henri-rodrigues/guardanapeiro-modular/docs/Encaixe_Botao_e_PortaBisnaga.pdf

Novo encaixe: botão de pressão (substitui o trilho) | Folha 1/2 · 16/09/2026 · mm · PLA/PETG

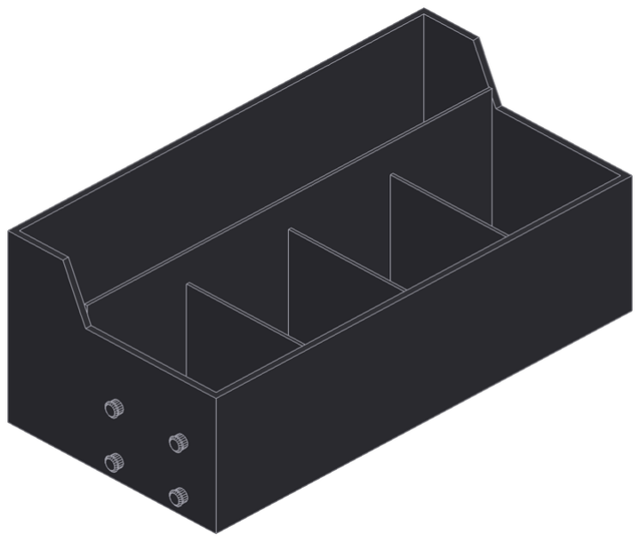
[picture p1: figure]

### ORGANIZADOR SEM NENHUM MÓDULO

só 4 botões de Ø6,8 mm em cada lateral — quase invisíveis de longe

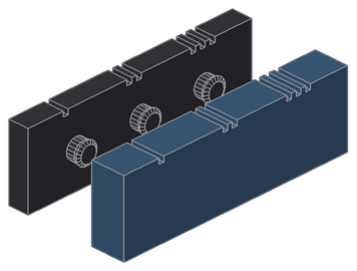
[picture p2: figure]

### PEÇAS DE TESTE DO BOTÃO

macho (3 cabeças: 6,6 / 6,8 / 7,0 mm) e fêmea — 1, 2 e 3 entalhes

## COMO FUNCIONA

O pino tem pescoço de Ø6,0 mm e cabeça abaulada de Ø6,8 mm. Ele entra num furo de Ø6,2 mm feito num disco fino de 1,3 mm, que flexiona na hora do encaixe e volta atrás da cabeça, travando. Depois do disco há um alívio de Ø8,6 mm, onde a cabeça se acomoda sem forçar.
São 4 botões por interface, num retângulo de 34 × 24 mm (y = 18 e 52; z = 9 e 33), o que segura o módulo contra giro e contra tombamento — mesmo sem trilho contínuo.

Vantagem em relação ao trilho: quando não há módulo instalado, a lateral fica lisa, com 4 pontinhos discretos, em vez de um trilho de 24 mm de altura aparecendo na peça.

Montagem: empurre o módulo de lado contra o organizador até ouvir/sentir o clique (antes era preciso descer o módulo por cima).

IMPORTANTE: imprima as duas peças de teste antes dos módulos — elas definem a cabeça certa para a sua impressora. Me diga qual das 3 (6,6 / 6,8 / 7,0) travou melhor e eu regero os STL.

Porta-bisnaga: versões de 3 e 6 bisnagas | Folha 2/2 · 16/09/2026 · mm · PLA/PETG

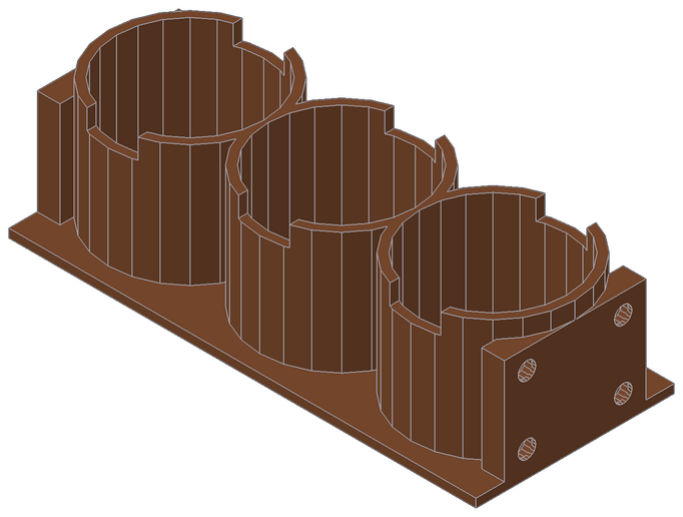
[picture p3: figure]

### VERSÃO A — 3 BISNAGAS EM LINHA

165 × 70 × 46 mm · volume sólido 106 cm³

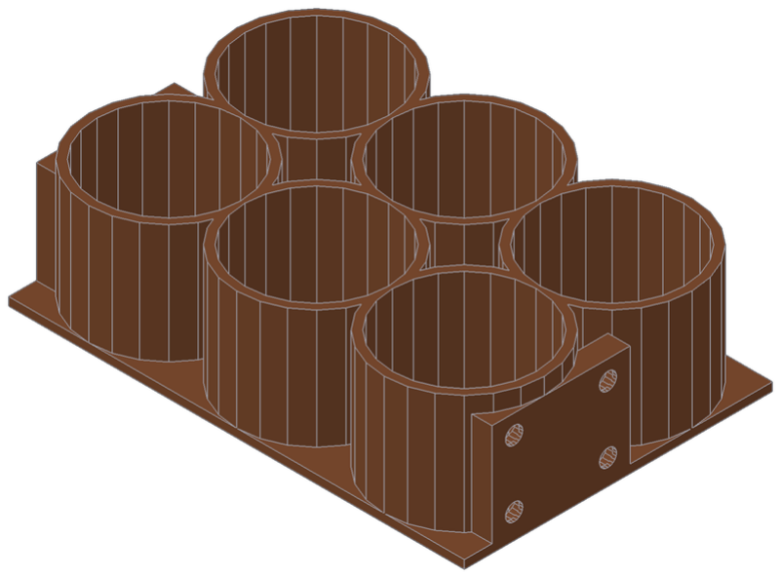
[picture p4: figure]

### VERSÃO B — 6 BISNAGAS (3 × 2)

165 × 111,5 × 46 mm · volume sólido 182 cm³

### DETALHES DOS DOIS

- Copo de Ø52 mm interno e 46 mm de altura — ajuste BOTTLE_D no script se a sua bisnaga for diferente.
- Copos vizinhos compartilham parede de 1,5 mm (centros a 53,5 mm), o que economiza material e espaço.
- Furo de dreno de Ø8 mm no fundo de cada copo.
- Versão A tem recortes laterais para tirar a bisnaga com os dedos; na versão B os copos do meio ficam cercados, então a retirada é por cima.
- Ambas têm a mesma interface de botão, então trocam de lugar com qualquer outro módulo.

### ARQUIVOS

Arquivo STL | Medidas (mm) | Observação
organizador_botoes.stl | 228 × 110 × 85 | substitui o da versão anterior
base_display_botoes.stl | 92 × 70 × 111 | bloco de encaixe mais alto (38 mm)
placa_cardapio.stl | 76 × 140 × 8 | não mudou
modulo_compartimentos_extras.stl | 48 × 70 × 60 | agora com botão
modulo_suporte_celular.stl | 68 × 70 × 84 | agora com botão
modulo_porta_bisnaga_3.stl | 169 × 70 × 46 | novo — 3 bisnagas
modulo_porta_bisnaga_6.stl | 169 × 111,5 × 46 | novo — 6 bisnagas
teste_botao_macho.stl / femea.stl | 10 × 70 × 22 | imprima primeiro
