henri-rodrigues/guardanapeiro-modular/docs/Modulos_Extras.pdf

# Sistema modular — visão geral

### MÓDULOS EXTRAS — ORGANIZADOR + CARDÁPIO DIGITAL

Folha 1/3 · 16/09/2026 · PLA/PETG preto · mm

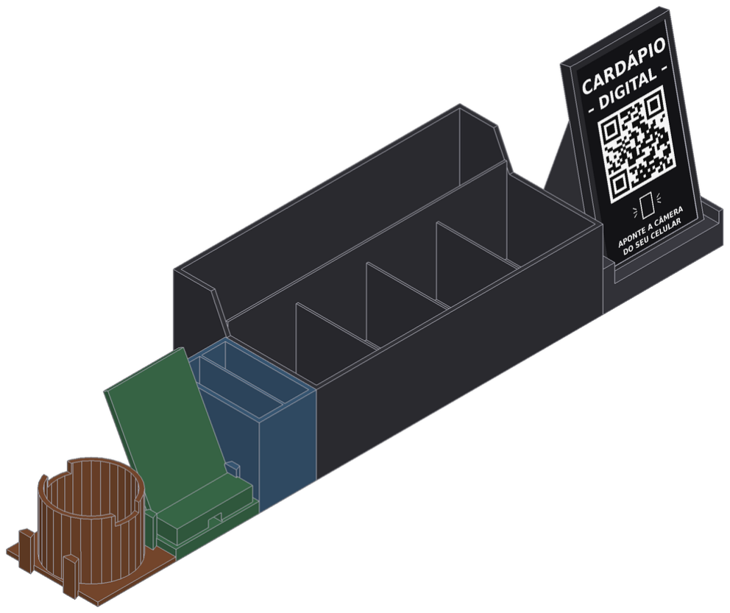
[picture p5: figure]

### ORGANIZADOR + 3 MÓDULOS ENCADEADOS NA LATERAL ESQUERDA

da esquerda p/ direita: porta-bisnaga · suporte de celular · compartimentos extras · organizador · base + placa

Porta-bisnaga | Suporte de celular | Compartimentos extras

## COMO FUNCIONA A INTERFACE

Todos os módulos usam o mesmo encaixe cauda-de-andorinha já validado entre organizador e base (6→9 mm, folga 0,15 mm).

- O organizador agora tem trilhos macho nos DOIS lados: o direito continua com a base do cardápio; o esquerdo é livre para qualquer módulo novo.
- Cada módulo tem um rasgo fêmea na face que encosta no organizador (ou no módulo anterior) — e um trilho macho na face de fora, para encaixar mais um módulo em fila.
- Montagem: cada peça desce por cima (vertical), como a base já fazia com o organizador.

### PROFUNDIDADE PADRÃO

Todo módulo tem 70 mm de profundidade (y), a mesma da base do display, com os trilhos nas mesmas posições
(y = 18 e 52 mm). Isso garante que qualquer combinação de módulos encaixa sem redesenhar nada.

### ARQUIVOS ATUALIZADOS

organizador_v2_trilhos_2_lados.stl substitui o organizador.stl da versão anterior (agora com trilho também do lado esquerdo). As demais peças (base, placa) continuam as mesmas.

### ENCAIXE

Mesma folga já testada na V1.1 (0,15 mm). Se seu teste de encaixe (folha anterior) pediu outra folga, me avise para eu regerar os STL com o valor certo.

# Especificação dos 3 módulos novos

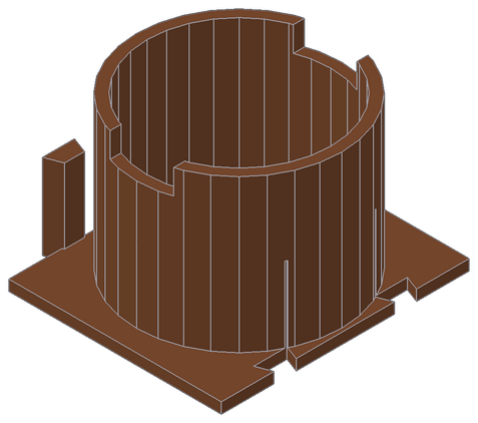
[picture p6: figure]

### MÓDULOS EXTRAS — ORGANIZADOR + CARDÁPIO DIGITAL

Folha 2/3 · 16/09/2026 · PLA/PETG preto · mm

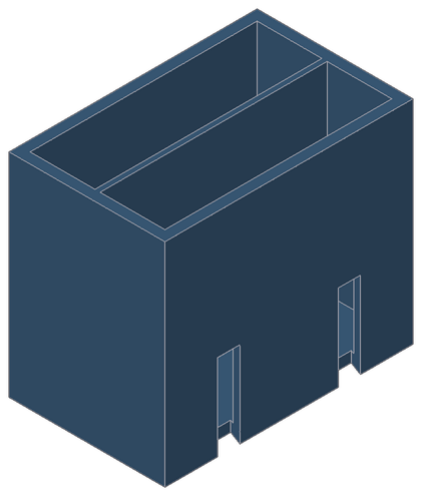
[picture p7: figure]

MÓDULO 1 — COMPARTIMENTOS EXTRAS

Largura × profundidade × altura
44 × 70 × 60 mm

Compartimentos
2 × 18,25 × 64 mm

Paredes / divisória

### 3 mm / 1,5 mm

Volume sólido

### 51.9 cm³

Bandeja simples com 2 vãos abertos — adoçante, canudo, palito ou um sachê extra. Mesma altura da parede frontal

do organizador (60 mm), para ficar visualmente alinhada.

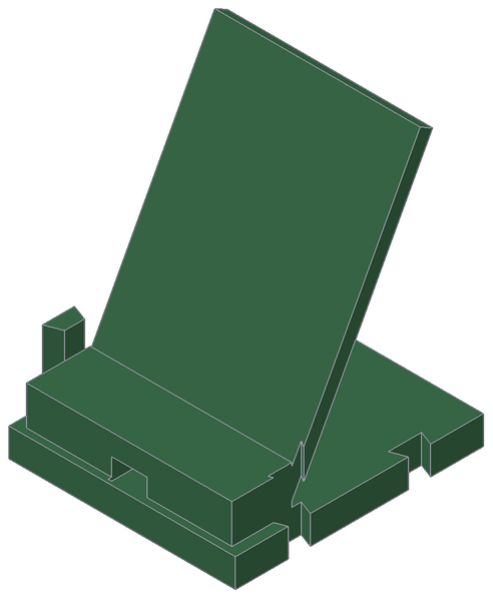
[picture p8: figure]

MÓDULO 2 — SUPORTE DE CELULAR/TABLET

Largura × profundidade × altura
64 × 70 × 84 mm

Inclinação do painel
28° da vertical

Bolso (funda) altura × profundidade 11 × 15 mm

Volume sólido

### 65.8 cm³

Painel de 4 mm apoiado num bolso frontal que segura a borda do aparelho; ranhura central de 10 mm para o cabo de carga passar por trás. Ajuste o ângulo (TILT2) no script

se preferir mais ou menos reclinado.

MÓDULO 3 — PORTA-BISNAGA

Largura × profundidade × altura
60 × 70 × 46 mm

Diâmetro interno do copo

### 52 mm

Furo de dreno
Ø 8 mm

Volume sólido

### 35.2 cm³

Copo cilíndrico com 2 recortes laterais para tirar a

bisnaga com os dedos, e furo de dreno no fundo. Ajuste BOTTLE_D no script para o diâmetro da sua

embalagem antes de imprimir.

# Impressão e montagem

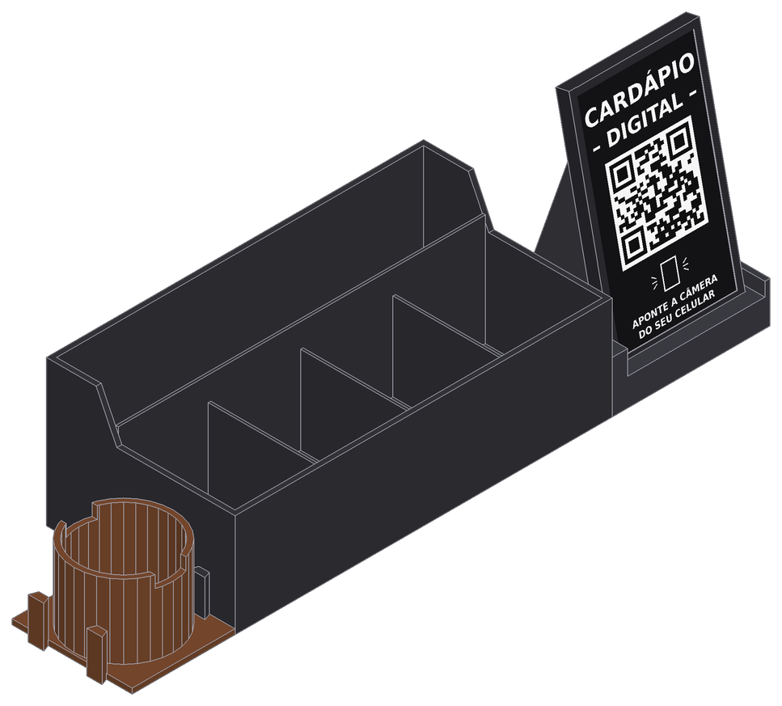
[picture p9: figure]

### MÓDULOS EXTRAS — ORGANIZADOR + CARDÁPIO DIGITAL

Folha 3/3 · 16/09/2026 · PLA/PETG preto · mm

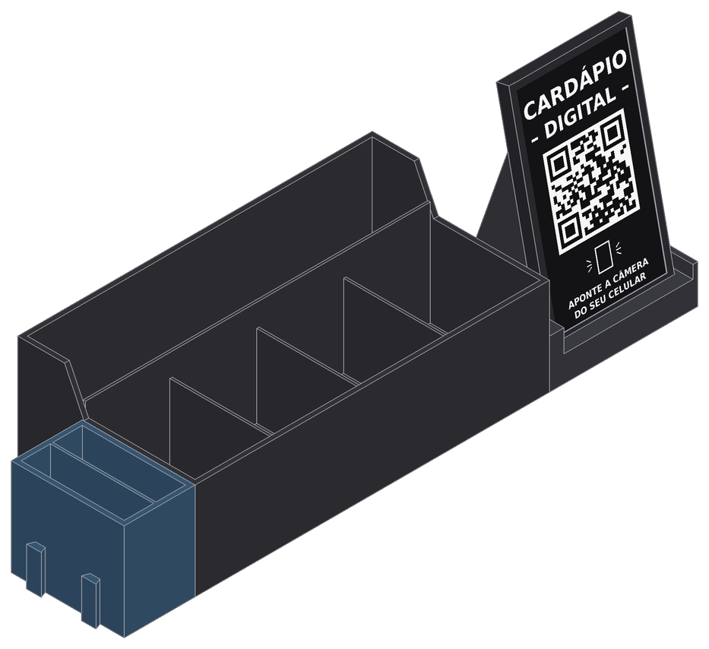
[picture p10: figure]
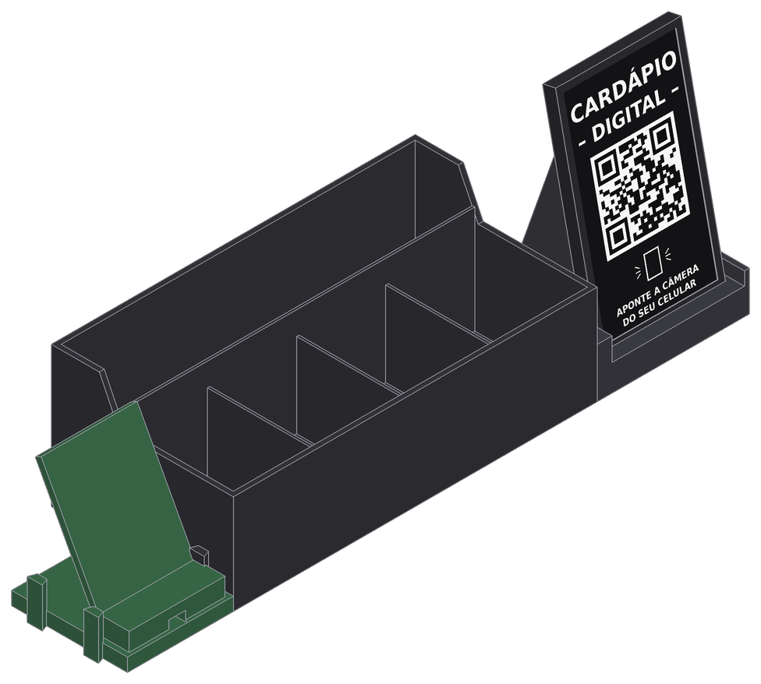
[picture p11: figure]

Compartimentos | Suporte de celular | Porta-bisnaga

### ARQUIVOS PARA IMPRESSÃO

Arquivo STL | Medidas (mm) | Posição na mesa | Sem suporte?
organizador_v2_trilhos_2_lados.stl | 228 × 110 × 85 | fundo na mesa | sim
modulo_compartimentos_extras.stl | 48 × 70 × 60 | fundo na mesa | sim
modulo_suporte_celular.stl | 68 × 70 × 84 | fundo na mesa | sim (painel apoiado)
modulo_porta_bisnaga.stl | 64 × 70 × 46 | fundo na mesa | sim

### COMO USAR

1. Se você já imprimiu o organizador da V1.1, troque só pelo novo organizador_v2_trilhos_2_lados.stl — o resto do conjunto (base, placa) não muda.
2. Escolha 1, 2 ou os 3 módulos e imprima com as mesmas configurações da V1.1: PLA/PETG, 4 paredes, 5 camadas de topo/fundo, 15% de preenchimento, sem suporte.
3. Encaixe o primeiro módulo por cima da lateral esquerda do organizador, deslizando para baixo até o fundo. Para encadear outro, repita o mesmo movimento encostando na face externa do módulo já encaixado.
4. A ordem dos módulos é livre — organize como preferir. Se algum ficar muito justo ou muito solto, ajuste a folga (mesma peça de teste da V1.1 serve para calibrar).
