henri-rodrigues/guardanapeiro-modular/site-3d/public/modelos/modulo_porta_bisnaga_6.stl

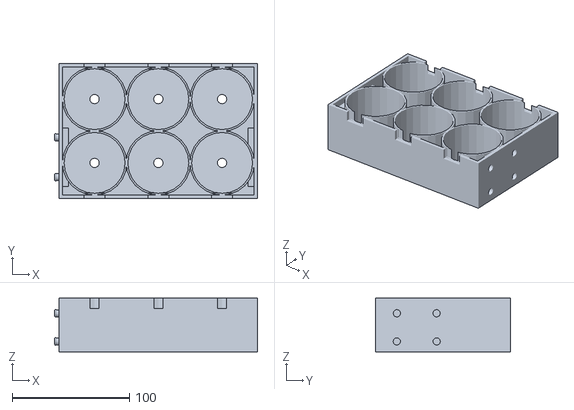
[picture p12: CAD file, 2026-09-18]
site-3d/public/modelos/modulo_porta_bisnaga_6.stl
173.2 x 114.8 x 46.0
