henri-rodrigues/guardanapeiro-modular/stl/modulo_compartimentos_2.stl

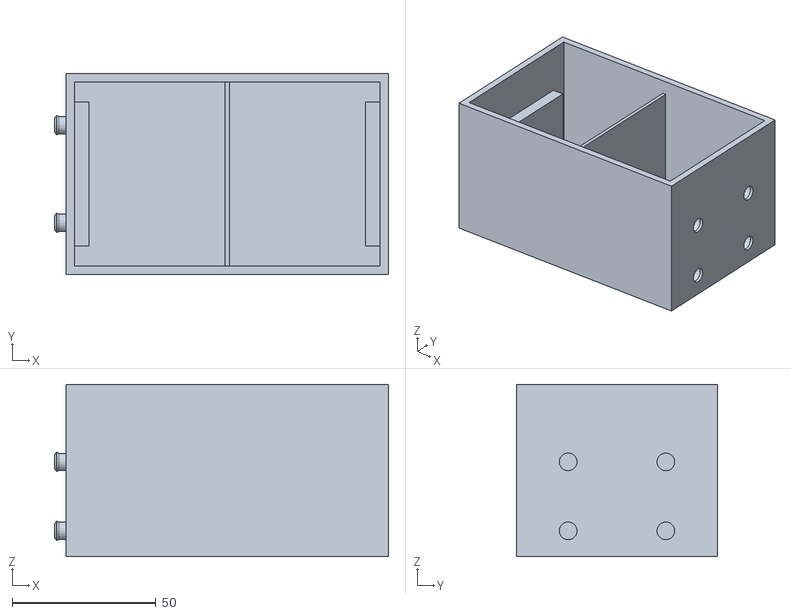
[picture p13: CAD file, 2026-09-18]
stl/modulo_compartimentos_2.stl
116.2 x 70.0 x 60.0
