henri-rodrigues/guardanapeiro-modular/site-3d/public/modelos/base_display_botoes.stl

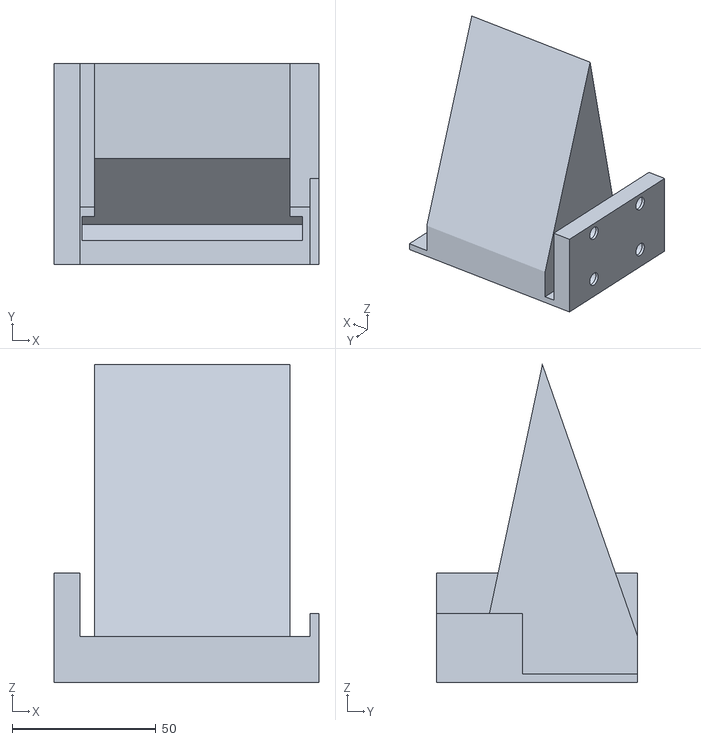
[picture p14: CAD file, 2026-09-18]
site-3d/public/modelos/base_display_botoes.stl
92.0 x 70.0 x 110.6
