henri-rodrigues/guardanapeiro-modular/stl/modulo_porta_bisnaga_3.stl

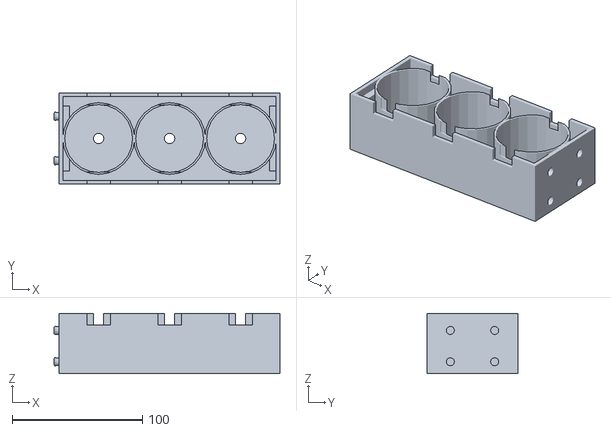
[picture p15: CAD file, 2026-09-18]
stl/modulo_porta_bisnaga_3.stl
173.2 x 70.0 x 46.0
