henri-rodrigues/guardanapeiro-modular/site-3d/public/modelos/organizador_botoes.stl

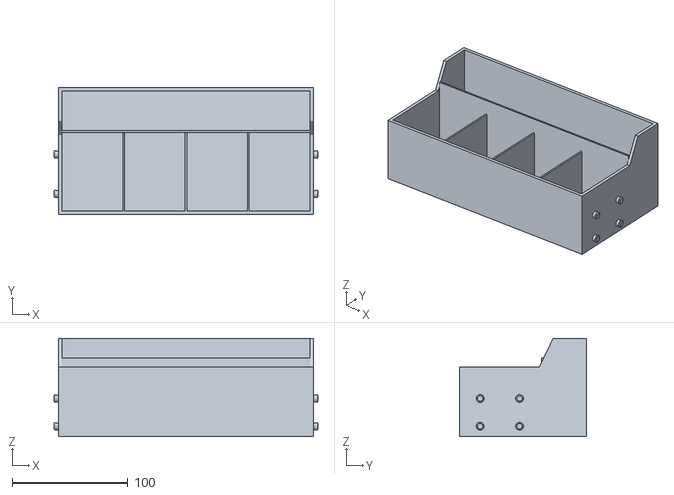
[picture p16: CAD file, 2026-09-18]
site-3d/public/modelos/organizador_botoes.stl
228.0 x 110.0 x 85.0
