henri-rodrigues/guardanapeiro-modular/stl/modulo_suporte_celular.stl

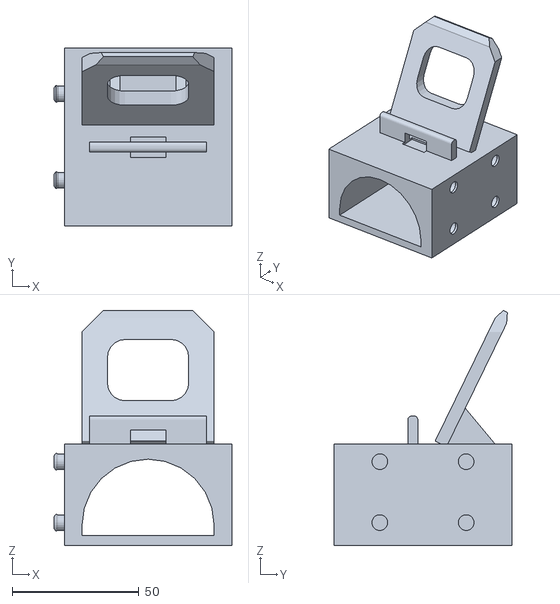
[picture p17: CAD file, 2026-09-18]
stl/modulo_suporte_celular.stl
70.0 x 70.0 x 92.5
