henri-rodrigues/guardanapeiro-modular/site-3d/public/modelos/modulo_compartimentos_3.stl

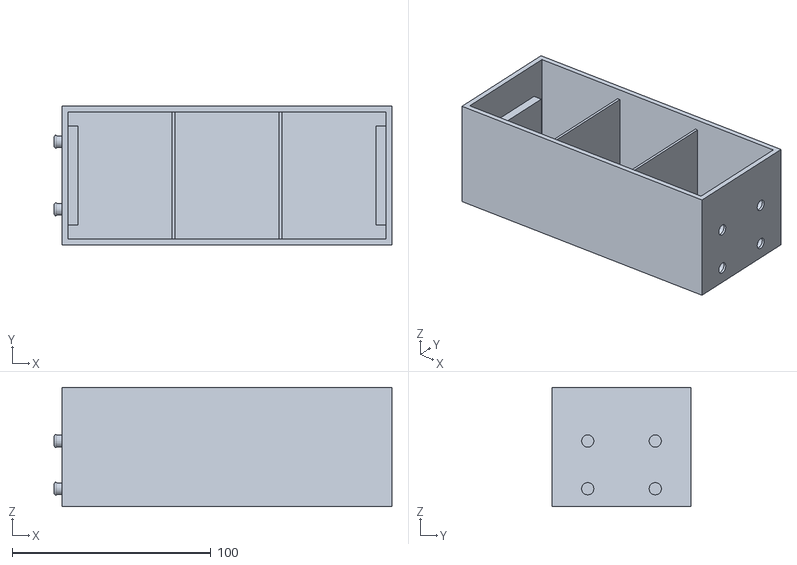
[picture p18: CAD file, 2026-09-18]
site-3d/public/modelos/modulo_compartimentos_3.stl
170.1 x 70.0 x 60.0
