henri-rodrigues/guardanapeiro-modular/stl/modulo_compartimentos_1.stl

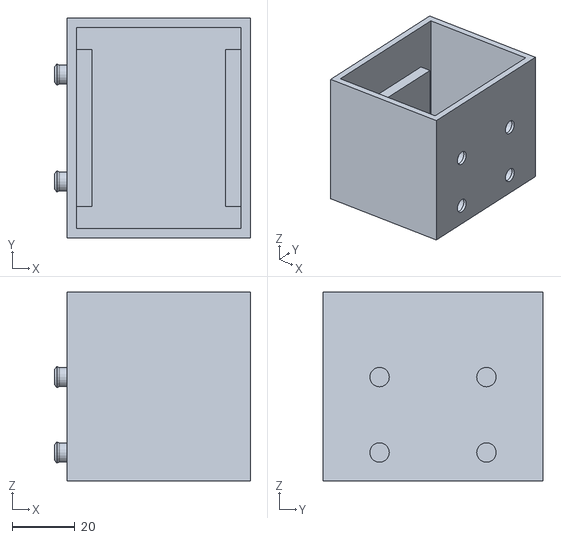
[picture p19: CAD file, 2026-09-18]
stl/modulo_compartimentos_1.stl
62.4 x 70.0 x 60.0
