henri-rodrigues/guardanapeiro-modular/stl/placa_cardapio.stl

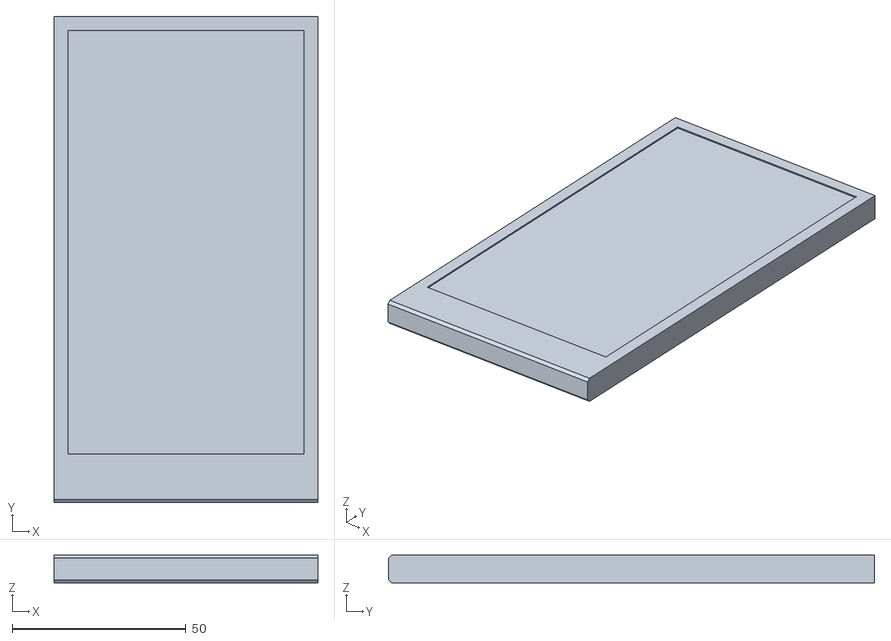
[picture p20: CAD file, 2026-09-18]
stl/placa_cardapio.stl
76.0 x 140.0 x 8.00
