henri-rodrigues/guardanapeiro-modular/stl/teste_botao_femea.stl

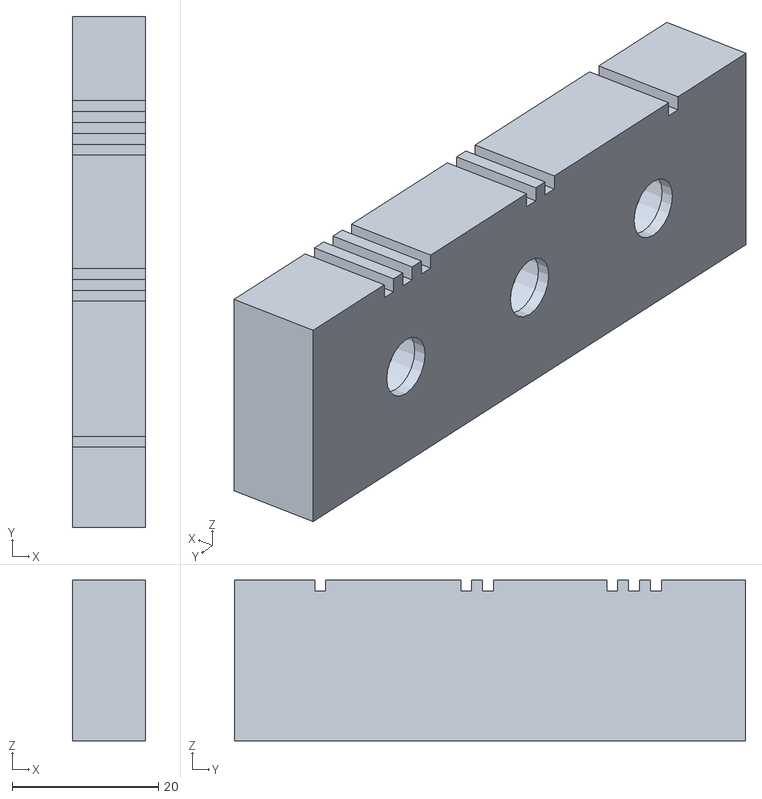
[picture p21: CAD file, 2026-09-18]
stl/teste_botao_femea.stl
10.0 x 70.0 x 22.0
