henri-rodrigues/guardanapeiro-modular/stl/modulo_compartimentos_extras.stl

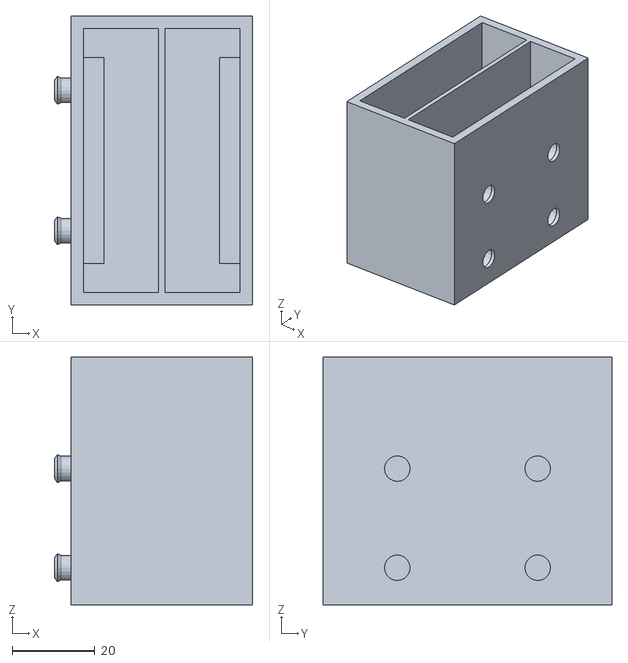
[picture p22: CAD file, 2026-09-18]
stl/modulo_compartimentos_extras.stl
48.0 x 70.0 x 60.0
