henri-rodrigues/guardanapeiro-modular/stl/teste_botao_macho.stl

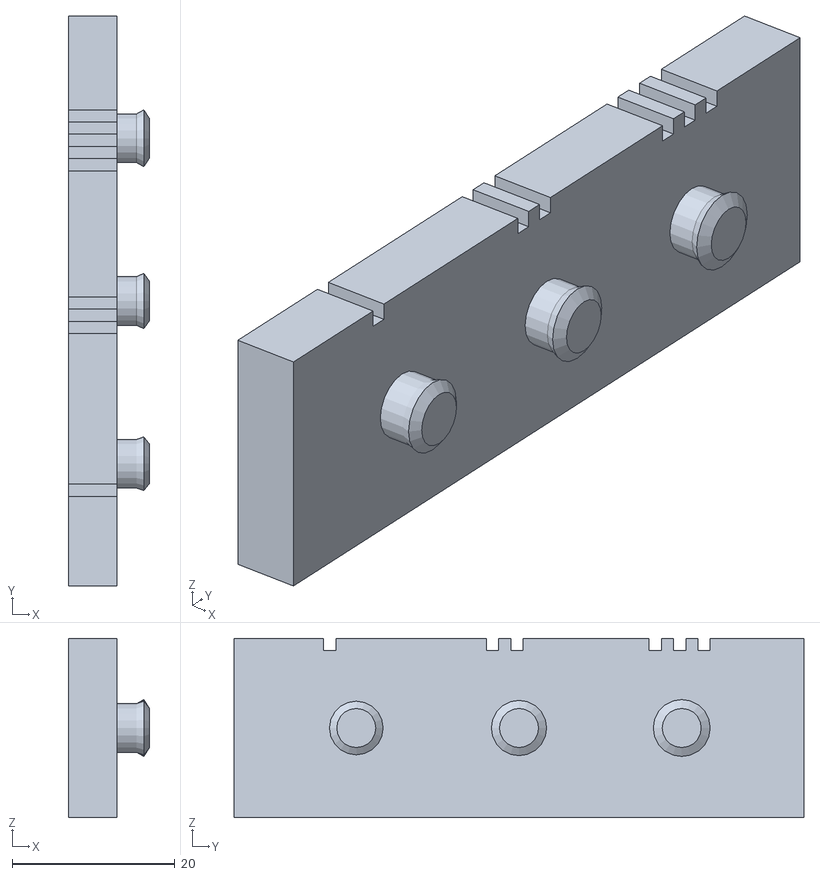
[picture p23: CAD file, 2026-09-18]
stl/teste_botao_macho.stl
10.0 x 70.0 x 22.0
