henri-rodrigues/guardanapeiro-modular/docs/Projeto_Organizador_Cardapio_Digital.pdf

# Vistas isométricas e visão geral

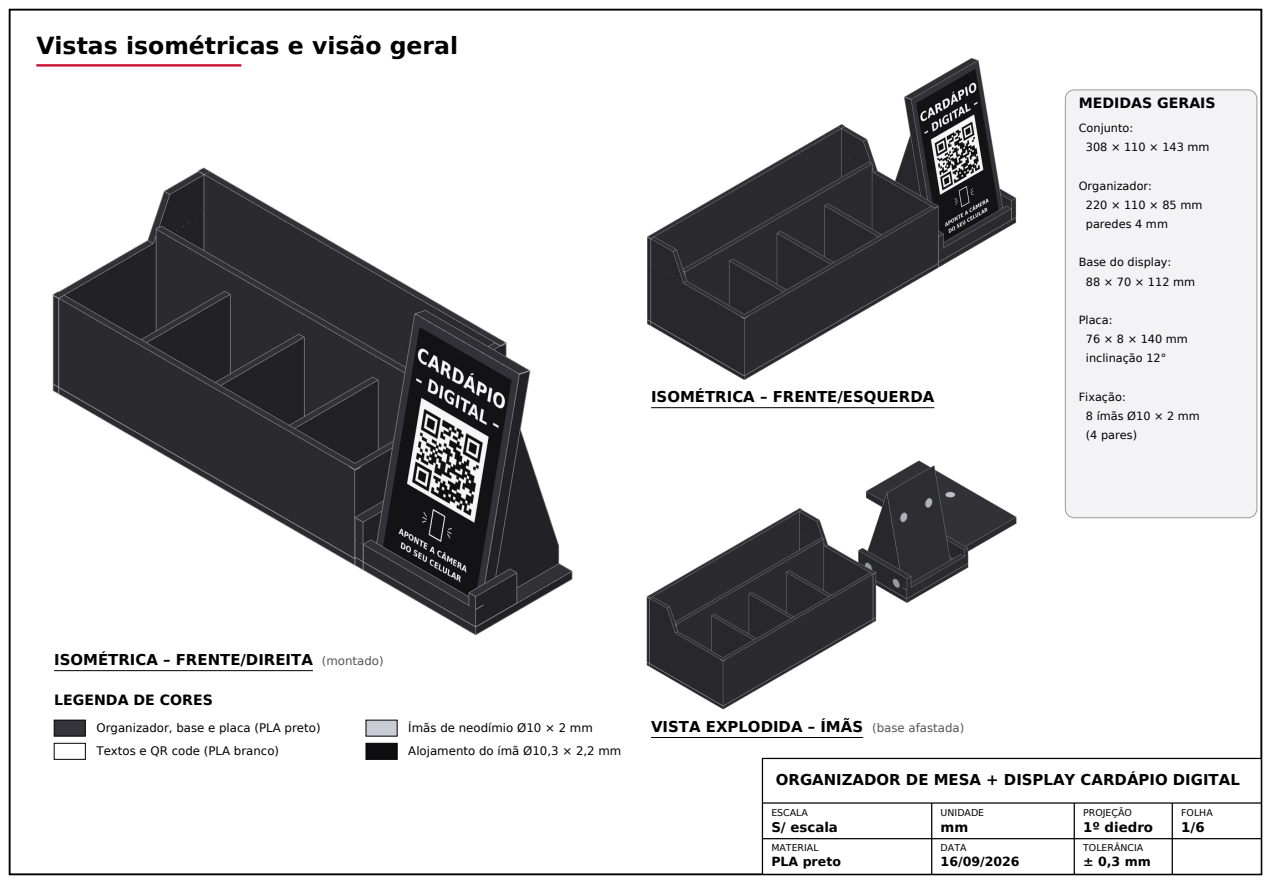
[picture p24: page 1]
MEDIDAS GERAIS; Conjunto:; Organizador:; paredes 4 mm; Placa:; inclinação 12°; Fixação:; 8 ímãs Ø10 × 2 mm; (4 pares)

Base do display:

ISOMÉTRICA – FRENTE/ESQUERDA

ISOMÉTRICA – FRENTE/DIREITA (montado)

LEGENDA DE CORES

Ímãs de neodímio Ø10 × 2 mm

VISTA EXPLODIDA – ÍMÃS (base afastada)

Organizador, base e placa (PLA preto)

Textos e QR code (PLA branco)

Alojamento do ímã Ø10,3 × 2,2 mm

ORGANIZADOR DE MESA + DISPLAY CARDÁPIO DIGITAL

ESCALA S/ escala | UNIDADE mm | PROJEÇÃO 1º diedro | FOLHA 1/6

MATERIAL PLA preto | DATA 16/09/2026 | TOLERÂNCIA ± 0,3 mm

# Vista frontal e vista superior

# CARDÁPIO

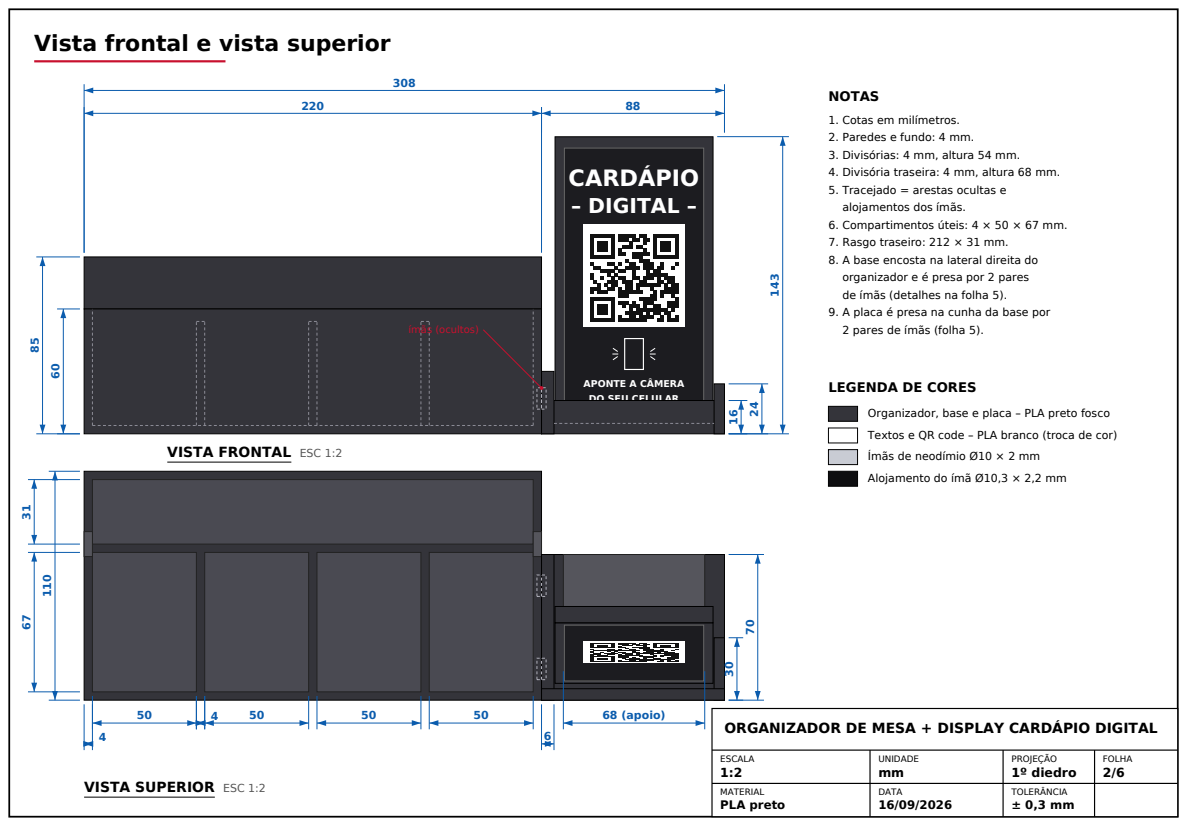
[picture p25: page 2]
ESCALA 1:2; UNIDADE mm; PROJEÇÃO 1º diedro; FOLHA 2/6; – DIGITAL –; ímãs (ocultos); 68 (apoio); NOTAS

1. Cotas em milímetros.
2. Paredes e fundo: 4 mm.
3. Divisórias: 4 mm, altura 54 mm.
4. Divisória traseira: 4 mm, altura 68 mm.
5. Tracejado = arestas ocultas e
alojamentos dos ímãs.
6. Compartimentos úteis: 4 × 50 × 67 mm.
7. Rasgo traseiro: 212 × 31 mm.
8. A base encosta na lateral direita do
organizador e é presa por 2 pares
de ímãs (detalhes na folha 5).
9. A placa é presa na cunha da base por
2 pares de ímãs (folha 5).

APONTE A CÂMERA
DO SEU CELULAR

LEGENDA DE CORES

Organizador, base e placa – PLA preto fosco

Textos e QR code – PLA branco (troca de cor)
Ímãs de neodímio Ø10 × 2 mm

VISTA FRONTAL ESC 1:2

Alojamento do ímã Ø10,3 × 2,2 mm

ORGANIZADOR DE MESA + DISPLAY CARDÁPIO DIGITAL

VISTA SUPERIOR ESC 1:2

# Vistas laterais

### VISTA LATERAL DIREITA – ORGANIZADOR ESC 1:1,25

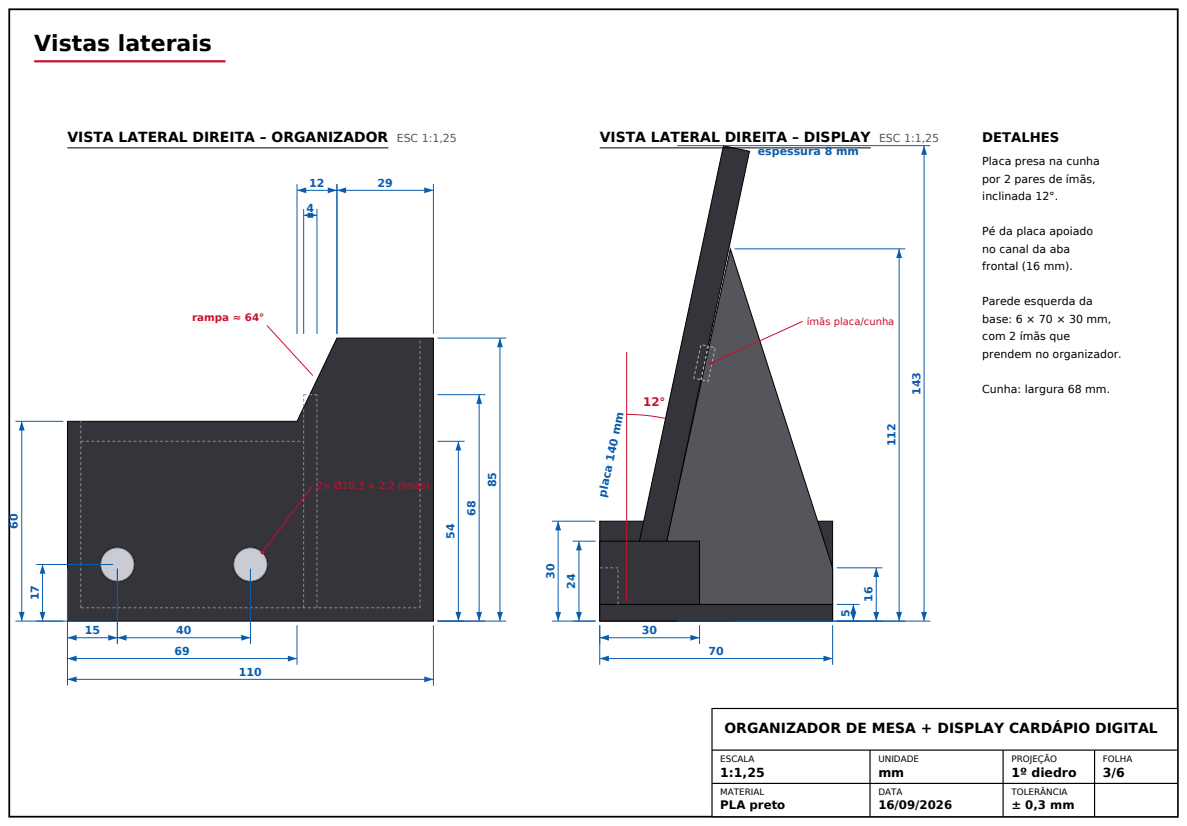
[picture p26: page 3]
ESCALA 1:1,25; UNIDADE mm; PROJEÇÃO 1º diedro; FOLHA 3/6; 2× Ø10,3 × 2,2 (ímãs); rampa ≈ 64°; ímãs placa/cunha; espessura 8 mm; placa 140 mm; DETALHES

VISTA LATERAL DIREITA – DISPLAY ESC 1:1,25

Placa presa na cunha
por 2 pares de ímãs,
inclinada 12°.

Pé da placa apoiado
no canal da aba
frontal (16 mm).

Parede esquerda da
base: 6 × 70 × 30 mm,
com 2 ímãs que
prendem no organizador.

Cunha: largura 68 mm.

ORGANIZADOR DE MESA + DISPLAY CARDÁPIO DIGITAL

# Detalhe da placa e lista de peças

# CARDÁPIO

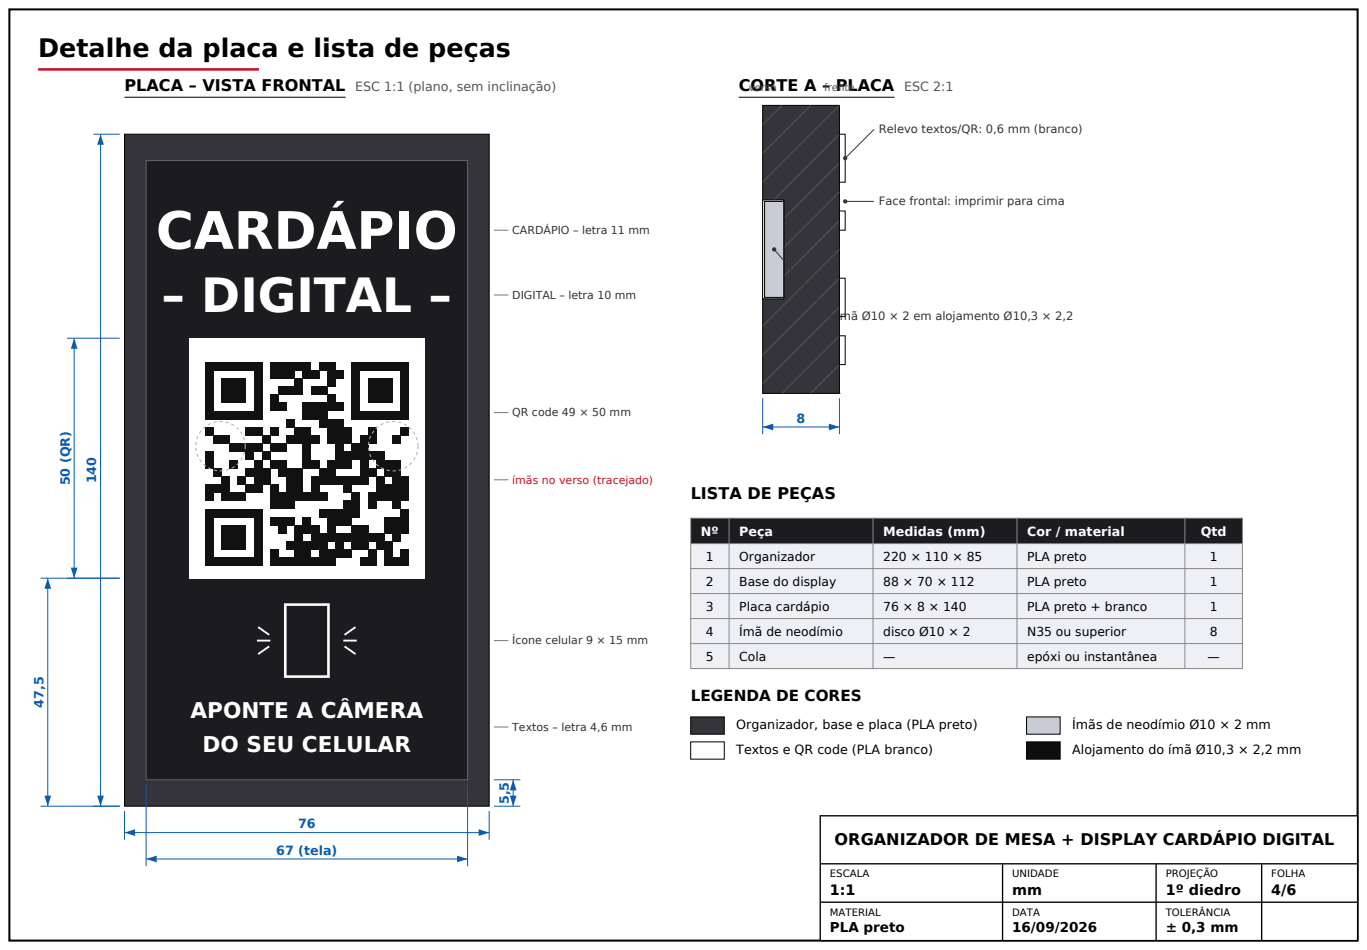
[picture p27: page 4]
ESCALA 1:1; UNIDADE mm; PROJEÇÃO 1º diedro; FOLHA 4/6; – DIGITAL –; 67 (tela); verso; frente

PLACA – VISTA FRONTAL ESC 1:1 (plano, sem inclinação)

CORTE A – PLACA ESC 2:1

Relevo textos/QR: 0,6 mm (branco)

Face frontal: imprimir para cima

CARDÁPIO – letra 11 mm

DIGITAL – letra 10 mm

Ímã Ø10 × 2 em alojamento Ø10,3 × 2,2

QR code 49 × 50 mm

ímãs no verso (tracejado)

LISTA DE PEÇAS

Nº | Peça | Medidas (mm) | Cor / material | Qtd

1 | Organizador | 220 × 110 × 85 | PLA preto | 1

2 | Base do display | 88 × 70 × 112 | PLA preto | 1

3 | Placa cardápio | 76 × 8 × 140 | PLA preto + branco | 1
4 | Ímã de neodímio | disco Ø10 × 2 | N35 ou superior | 8

Ícone celular 9 × 15 mm

5 | Cola | — | epóxi ou instantânea | —

LEGENDA DE CORES

APONTE A CÂMERA
DO SEU CELULAR

Textos – letra 4,6 mm

Organizador, base e placa (PLA preto)

Ímãs de neodímio Ø10 × 2 mm

Textos e QR code (PLA branco)

Alojamento do ímã Ø10,3 × 2,2 mm

ORGANIZADOR DE MESA + DISPLAY CARDÁPIO DIGITAL

# Fixação por ímãs

### BASE – LATERAL ESQUERDA ESC 1:1,25

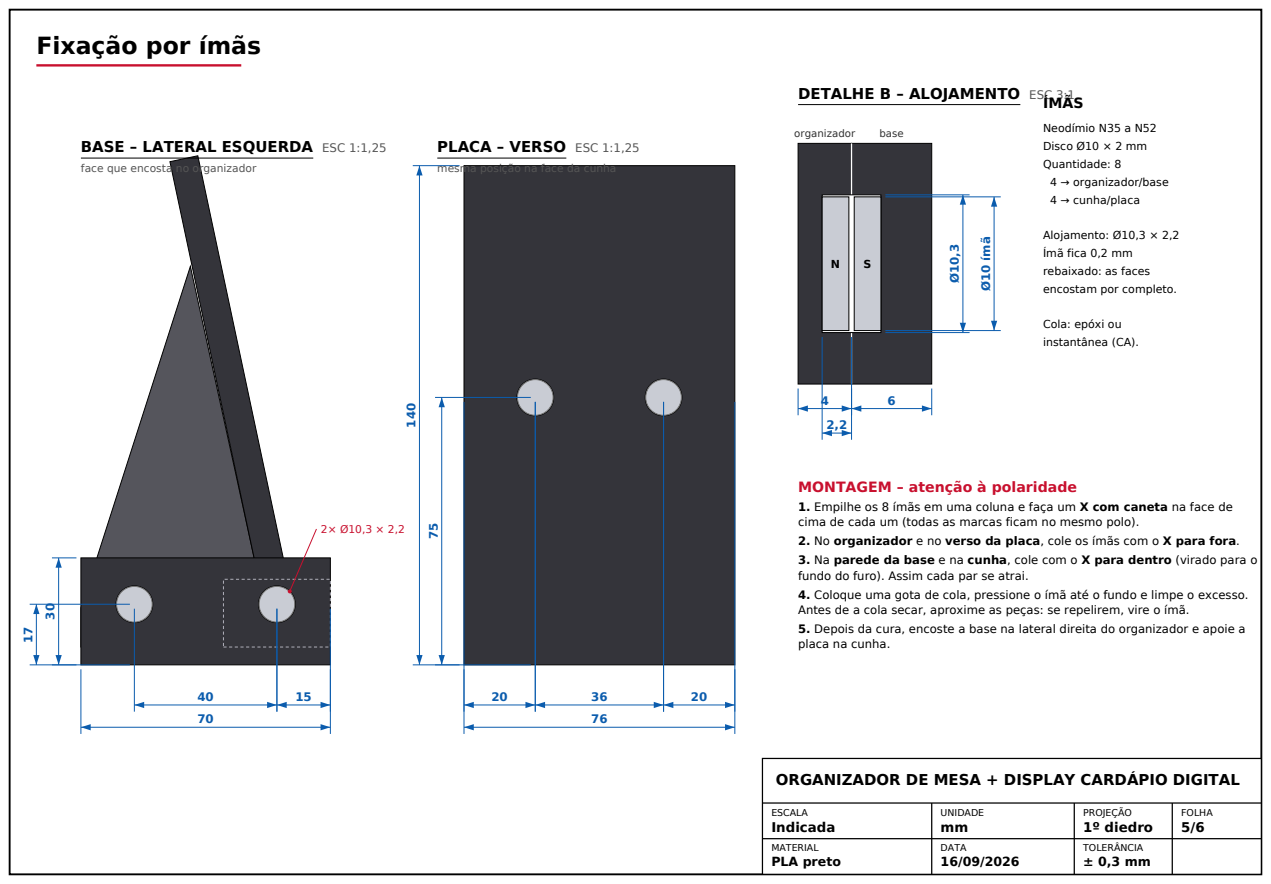
[picture p28: page 5]
ESCALA Indicada; UNIDADE mm; PROJEÇÃO 1º diedro; FOLHA 5/6; organizador; base; Ø10 ímã; ÍMÃS; Neodímio N35 a N52; Disco Ø10 × 2 mm; Quantidade: 8; 4 → organizador/base; 4 → cunha/placa

DETALHE B – ALOJAMENTO ESC 3:1

PLACA – VERSO ESC 1:1,25

face que encosta no organizador

mesma posição na face da cunha

Alojamento: Ø10,3 × 2,2
Ímã fica 0,2 mm
rebaixado: as faces
encostam por completo.

Cola: epóxi ou
instantânea (CA).

MONTAGEM – atenção à polaridade
1. Empilhe os 8 ímãs em uma coluna e faça um X com caneta na face de
cima de cada um (todas as marcas ficam no mesmo polo).
2. No organizador e no verso da placa, cole os ímãs com o X para fora.
3. Na parede da base e na cunha, cole com o X para dentro (virado para o
fundo do furo). Assim cada par se atrai.
4. Coloque uma gota de cola, pressione o ímã até o fundo e limpe o excesso.
Antes de a cola secar, aproxime as peças: se repelirem, vire o ímã.
5. Depois da cura, encoste a base na lateral direita do organizador e apoie a
placa na cunha.

ORGANIZADOR DE MESA + DISPLAY CARDÁPIO DIGITAL

# Guia de impressão 3D

### ORGANIZADOR DE MESA + DISPLAY CARDÁPIO DIGITAL

ESCALA
S/ escala

UNIDADE
mm

PROJEÇÃO
1º diedro

FOLHA
6/6

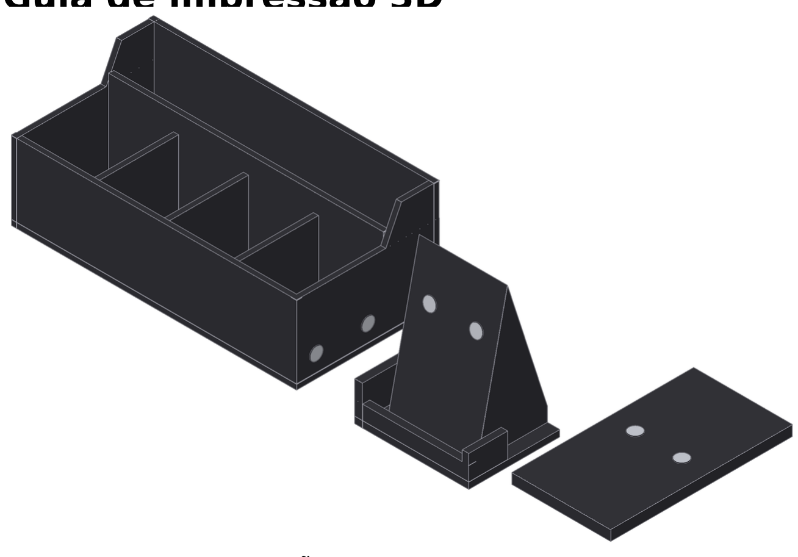
[picture p29: figure]

### PEÇAS PARA IMPRESSÃO

(1) organizador (2) base do display (3) placa – ímãs em cinza claro

### 1. Exportar do Blender (STL)

Rode o script: os furos dos ímãs já são feitos por modificadores Boolean. Selecione cada peça e use Object › Convert › Mesh para aplicar os modificadores. Na placa, converta também os textos e junte tudo com Ctrl+J. File › Export › STL, com Selection Only e Scale = 10 (modelo em cm, fatiador em mm). Gere 3 arquivos: organizador, base e placa.

### 2. Fatiador (Bambu Studio, OrcaSlicer, PrusaSlicer ou Cura)

Confira o organizador com 220 mm de largura. Em mesa de 220 × 220 mm fica justo: gire 45° ou reduza para 97% (reduza as 3 peças igualmente e ajuste os furos para continuarem com 10,3 mm).
Organizador e base com o fundo na mesa; placa deitada com os textos para cima. Nenhuma peça precisa de suporte: os furos laterais são pequenos e o furo do verso da placa fica virado para a mesa.

### 3. Configurações (PLA, bico 0,4)

Camada 0,2 mm (0,12 mm na placa) · 3 perímetros · 5 camadas de topo e fundo · preenchimento 15–20% gyroid · bico 205–215 °C · mesa 60 °C · brim de 5 mm no organizador.

### 4. Textos e QR code em branco

Com vários filamentos (AMS/MMU), pinte os textos de branco no fatiador. Com uma cor só, adicione troca de filamento (M600) na camada de 8,0 mm. O QR do desenho é ilustrativo: gere o QR do seu cardápio, importe em SVG com 0,6 mm de relevo ou use um adesivo, e teste a leitura antes.

### 5. Ímãs

Compre 8 ímãs de neodímio Ø10 × 2 mm. Primeiro teste um ímã no furo: se entrar apertado, aumente o furo para 10,4–10,5 mm; se ficar folgado, a cola resolve. Siga a sequência de polaridade da folha 5 antes de colar.

### 6. Tempo e material (estimativa)

Organizador 7–10 h, ~180 g · Base 2–3 h, ~55 g · Placa 2–3 h, ~40 g. O fatiador mostra os valores exatos.

Parâmetro | Organizador | Base | Placa
Altura de camada | 0,2 mm | 0,2 mm | 0,12 mm
Perímetros | 3 | 3 | 3
Preenchimento | 15% | 20% | 20%
Suporte | não | não | não
Aderência | brim 5 mm | saia | saia
Orientação | fundo na mesa | fundo na mesa | textos p/ cima
Furos dos ímãs | lateral | lateral + cunha | verso (na mesa)

Obs.: PLA comum não é certificado para contato com alimentos.
