henri-rodrigues/guardanapeiro-modular/docs/Projeto_Organizador_Cardapio_V1-1.pdf

# Visão geral – V1.1

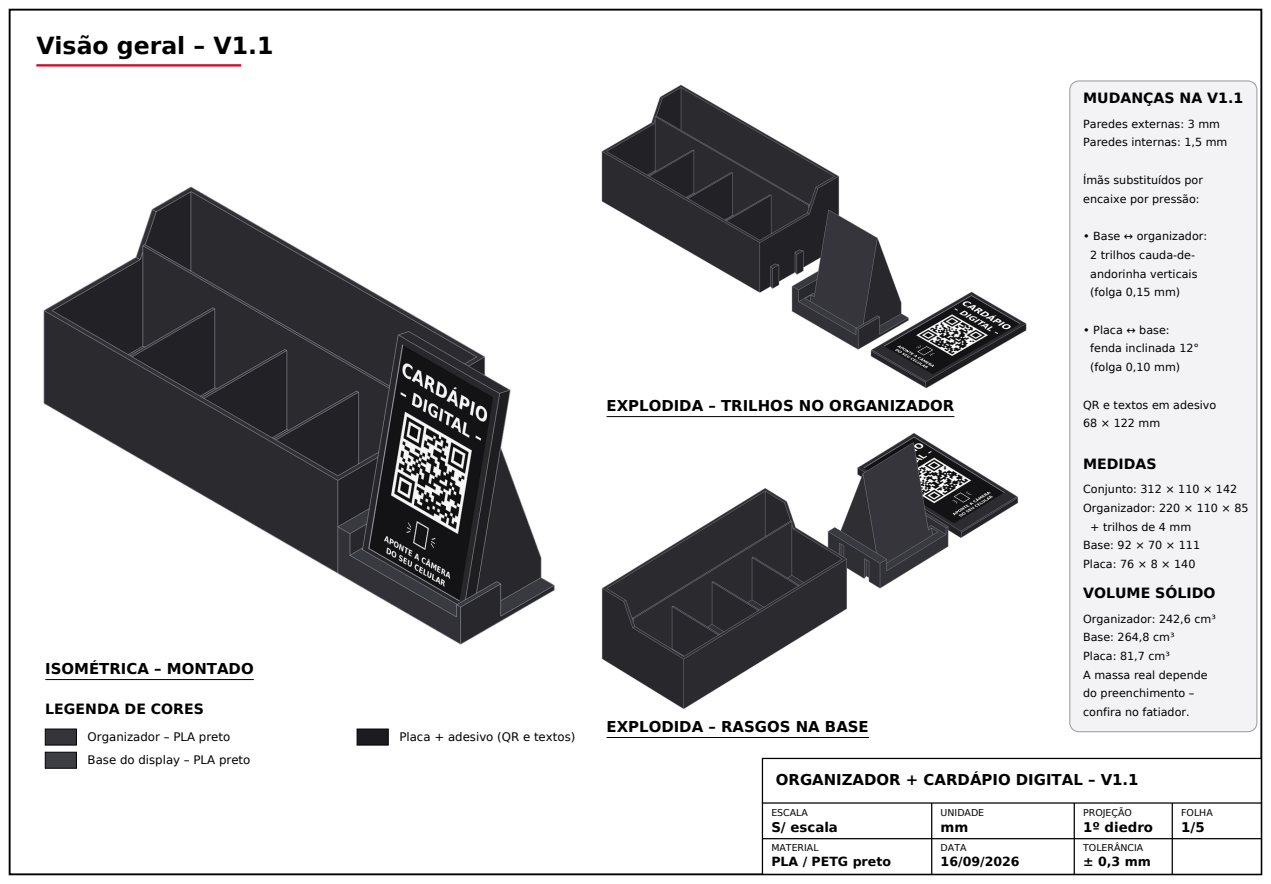
[picture p30: page 1]
ISOMÉTRICA – MONTADO; MUDANÇAS NA V1.1; • Placa ↔ base:; fenda inclinada 12°; (folga 0,10 mm); MEDIDAS

Paredes externas: 3 mm
Paredes internas: 1,5 mm

Ímãs substituídos por
encaixe por pressão:

• Base ↔ organizador:
2 trilhos cauda-de-
andorinha verticais
(folga 0,15 mm)

EXPLODIDA – TRILHOS NO ORGANIZADOR

QR e textos em adesivo

Conjunto: 312 × 110 × 142
Organizador: 220 × 110 × 85
+ trilhos de 4 mm
Base: 92 × 70 × 111
Placa: 76 × 8 × 140
VOLUME SÓLIDO

Organizador: 242,6 cm³
Base: 264,8 cm³
Placa: 81,7 cm³
A massa real depende
do preenchimento –
confira no fatiador.

LEGENDA DE CORES

EXPLODIDA – RASGOS NA BASE

Organizador – PLA preto

Placa + adesivo (QR e textos)

Base do display – PLA preto

ORGANIZADOR + CARDÁPIO DIGITAL – V1.1

ESCALA S/ escala | UNIDADE mm | PROJEÇÃO 1º diedro | FOLHA 1/5

MATERIAL PLA / PETG preto | DATA 16/09/2026 | TOLERÂNCIA ± 0,3 mm

# Vista frontal e vista superior

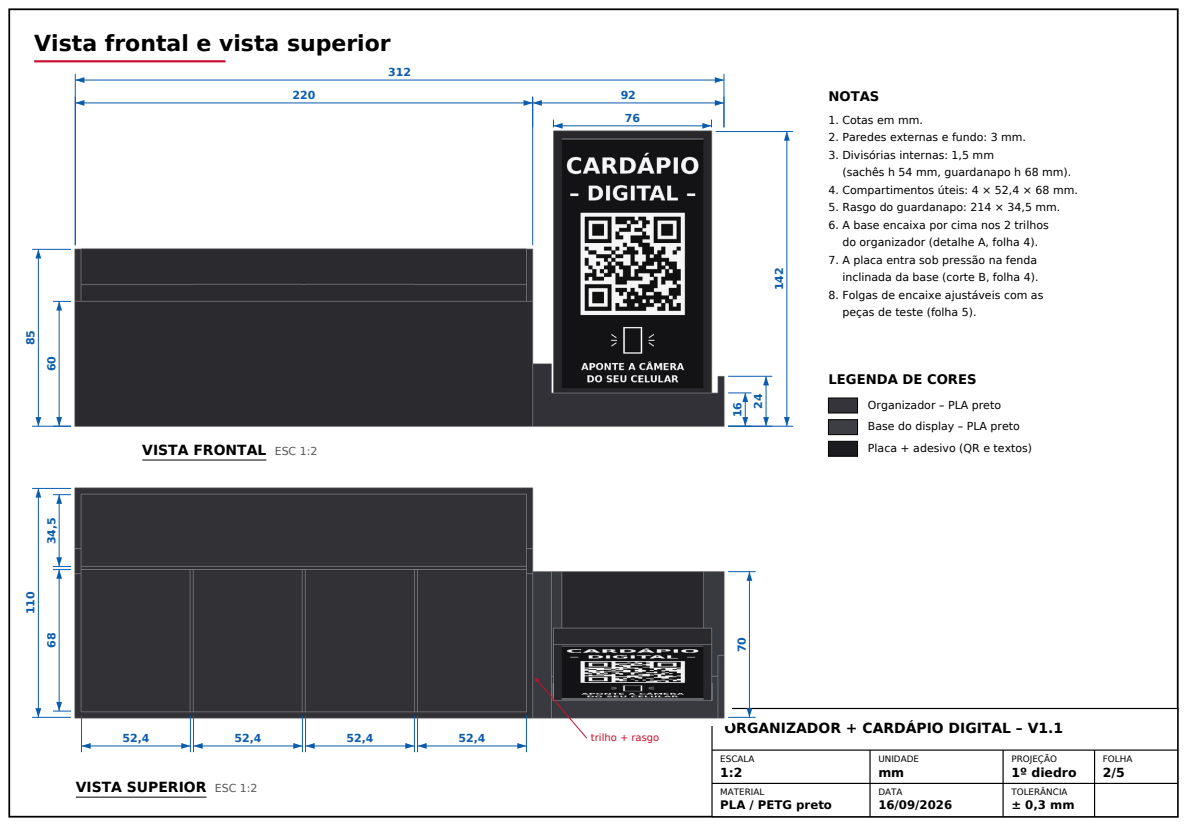
[picture p31: page 2]
ESCALA 1:2; UNIDADE mm; PROJEÇÃO 1º diedro; FOLHA 2/5; trilho + rasgo; NOTAS

1. Cotas em mm.
2. Paredes externas e fundo: 3 mm.
3. Divisórias internas: 1,5 mm
(sachês h 54 mm, guardanapo h 68 mm).
4. Compartimentos úteis: 4 × 52,4 × 68 mm.
5. Rasgo do guardanapo: 214 × 34,5 mm.
6. A base encaixa por cima nos 2 trilhos
do organizador (detalhe A, folha 4).
7. A placa entra sob pressão na fenda
inclinada da base (corte B, folha 4).
8. Folgas de encaixe ajustáveis com as
peças de teste (folha 5).

LEGENDA DE CORES

Organizador – PLA preto

Base do display – PLA preto

VISTA FRONTAL ESC 1:2

Placa + adesivo (QR e textos)

ORGANIZADOR + CARDÁPIO DIGITAL – V1.1

VISTA SUPERIOR ESC 1:2

# Vistas laterais

### VISTA LATERAL DIREITA ESC 1:1,25

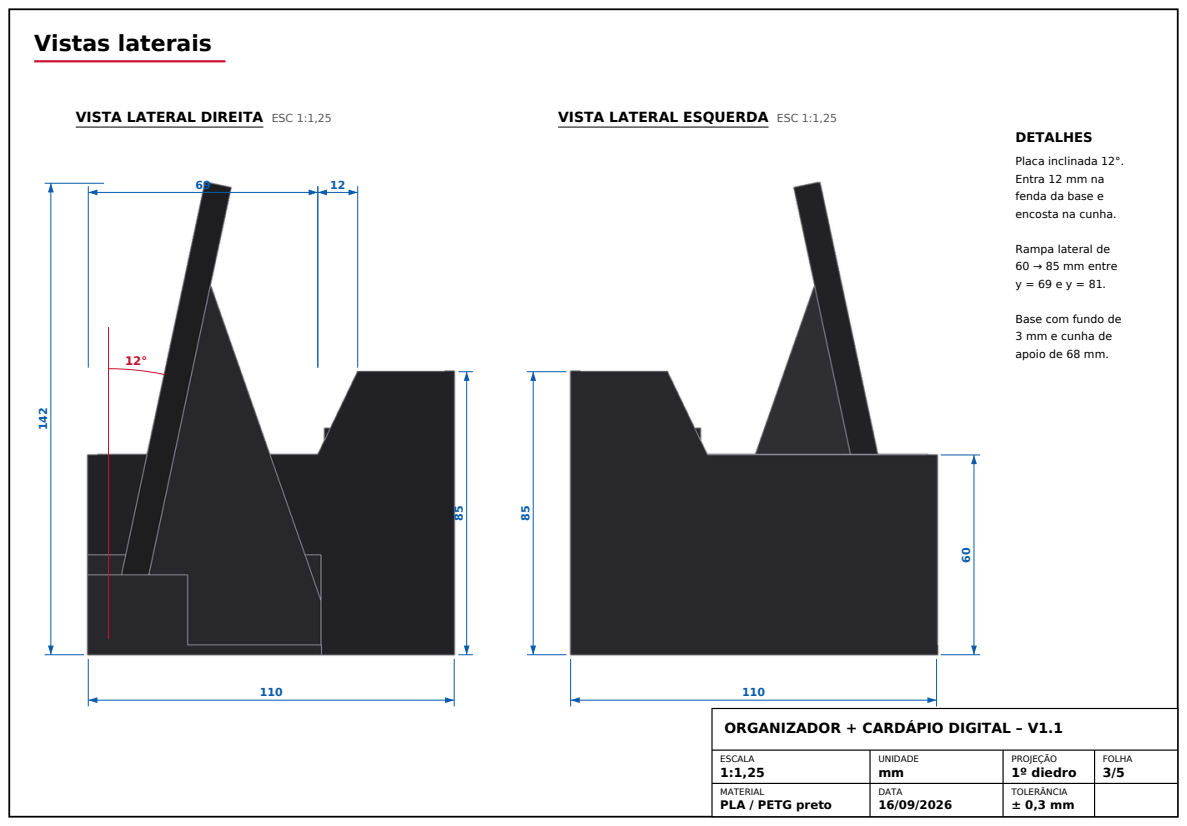
[picture p32: page 3]
ESCALA 1:1,25; UNIDADE mm; PROJEÇÃO 1º diedro; FOLHA 3/5; DETALHES

VISTA LATERAL ESQUERDA ESC 1:1,25

Placa inclinada 12°.
Entra 12 mm na
fenda da base e
encosta na cunha.

Rampa lateral de
60 → 85 mm entre

Base com fundo de
3 mm e cunha de
apoio de 68 mm.

ORGANIZADOR + CARDÁPIO DIGITAL – V1.1

# Detalhes dos encaixes por pressão

### DETALHE A – TRILHO CAUDA-DE-ANDORINHA

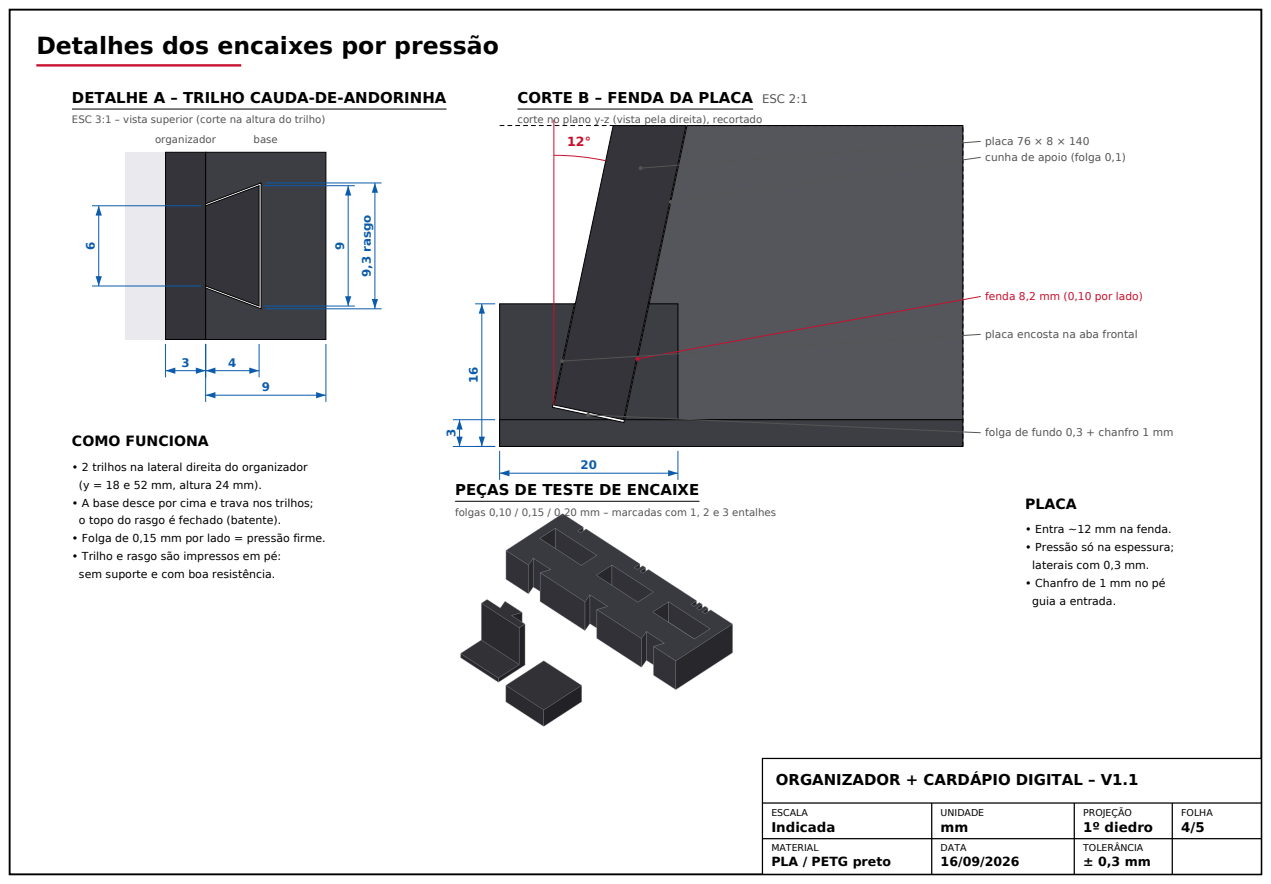
[picture p33: page 4]
ESCALA Indicada; UNIDADE mm; PROJEÇÃO 1º diedro; FOLHA 4/5; organizador; base; 9,3 rasgo; COMO FUNCIONA; PLACA

CORTE B – FENDA DA PLACA ESC 2:1

ESC 3:1 – vista superior (corte na altura do trilho)

corte no plano y-z (vista pela direita), recortado

placa 76 × 8 × 140
cunha de apoio (folga 0,1)

fenda 8,2 mm (0,10 por lado)

placa encosta na aba frontal

folga de fundo 0,3 + chanfro 1 mm

• 2 trilhos na lateral direita do organizador
(y = 18 e 52 mm, altura 24 mm).
• A base desce por cima e trava nos trilhos;
o topo do rasgo é fechado (batente).
• Folga de 0,15 mm por lado = pressão firme.
• Trilho e rasgo são impressos em pé:
sem suporte e com boa resistência.

PEÇAS DE TESTE DE ENCAIXE

folgas 0,10 / 0,15 / 0,20 mm – marcadas com 1, 2 e 3 entalhes

• Entra ~12 mm na fenda.
• Pressão só na espessura;
laterais com 0,3 mm.
• Chanfro de 1 mm no pé
guia a entrada.

ORGANIZADOR + CARDÁPIO DIGITAL – V1.1

# Placa, adesivo e impressão 3D

### ORGANIZADOR + CARDÁPIO DIGITAL – V1.1

ESCALA
Indicada

UNIDADE
mm

PROJEÇÃO
1º diedro

FOLHA
5/5

### PLACA – FRENTE ESC 1:1,25

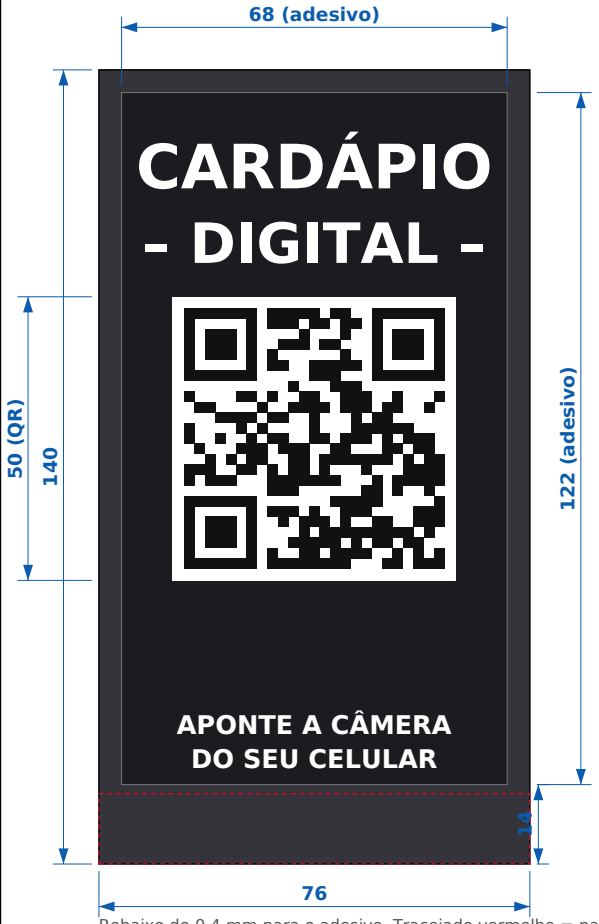
[picture p34: figure]
CARDÁPIO; – DIGITAL –; APONTE A CÂMERA; DO SEU CELULAR; 68 (adesivo); 122 (adesivo)

Rebaixo de 0,4 mm para o adesivo. Tracejado vermelho = parte que entra na fenda.

### ARQUIVOS PARA IMPRESSÃO

Arquivo STL | Peça | Medidas (mm) | Posição na mesa
organizador.stl | Organizador | 224 × 110 × 85 | fundo na mesa
base_display.stl | Base do display | 92 × 70 × 111 | fundo na mesa
placa_cardapio.stl | Placa | 76 × 140 × 8 | verso na mesa
teste_encaixe_femea.stl | Teste (rasgos) | 90 × 30 × 14 | fundo na mesa
teste_encaixe_macho.stl | Teste (trilho) | 50 × 24 × 20 | como no arquivo

### 1. Imprima primeiro o teste de encaixe (≈ 30 min)

O bloco tem 3 rasgos e 3 fendas com folgas de 0,10 (1 entalhe), 0,15 (2) e 0,20 mm (3). Encaixe o trilho e a lâmina de 8 mm em cada um. O ideal é entrar com pressão firme da mão, sem martelo.

### 2. Se o encaixe ficar justo ou folgado

Os STL usam 0,15 mm no trilho e 0,10 mm na placa. Se o seu teste pedir outra folga, no Bambu Studio use Qualidade › Compensação de contorno XY só na base (ex.: −0,05 mm alarga os rasgos) ou me peça os STL com a nova folga.

### 3. Configurações (Bambu Studio, bico 0,4)

PLA ou PETG · camada 0,2 mm · 4 paredes (≈1,6 mm; a parede de 3 mm fica sólida) · 5 camadas de topo e fundo · preenchimento 15% gyroid · sem suporte · brim de 5 mm no organizador · desligue "Elephant foot compensation" só se o teste mostrar folga demais na base dos rasgos.

### 4. Montagem

Desça a base por cima dos trilhos até o fundo encostar na mesa. Cole o adesivo no rebaixo da placa e empurre o pé da placa na fenda até encostar na cunha.
