henri-rodrigues/guardanapeiro-modular/(commit log)

2026-09-18 Initial commit: Guardanapeiro Modular Organizador (CAD + site 3D)
    Peça base modular + módulos de encaixe (compartimentos, suporte de
    celular/tablet, porta-bisnaga) com encaixe por botão de pressão, CAD
    paramétrico em Python puro e landing page com configurador 3D
    (Three.js) que deduz cores/estilo da logo do cliente.
    [base_display_botoes.stl, modulo_compartimentos_1.stl, modulo_compartimentos_2.stl, modulo_compartimentos_3.stl, modulo_compartimentos_extras.stl, modulo_porta_bisnaga_3.stl, modulo_porta_bisnaga_6.stl, modulo_suporte_celular.stl]
2026-09-18 Fix: import map estático com specifiers relativos válidos
    Especificadores de import map precisam começar com "./", "/" ou ser URL
    absoluta -- um caminho relativo "nu" (sem "./") é rejeitado pelo browser
    como "bare specifier", quebrando o carregamento do Three.js. Também
    troca a detecção via XHR síncrono (que tinha uma race condition) por um
    import map estático, já que o vendor/three agora está sempre versionado.
2026-09-18 Add sales concept catalog: product in bar-counter scenes with client branding
    New cad/catalog_render.py generates isometric renders of the assembled
    product (with modules chained) on a stylized bar-counter scene, plus
    standalone module packshots and color swatches, all reusing the existing
    raster.py engine. cad/catalog_pdf.py composes them into a 7-page PDF
    (cover, contents, lifestyle shot, module spec sheet, personalization
    page, technical specs, contact page) for the sales team to show clients
    before ordering.
    Brand demo (name/colors/table number) is a single config dict in
    catalog_render.py, so a real client's identity can be swapped in and
    the catalog regenerated for them.
    Co-Authored-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
